rsre3546r-oss/Robert-Smith-Rosario-Estevez-PLC4UNI/Tarea 6/ENSAMBLE/Ensamble PCB Vertical.STEP

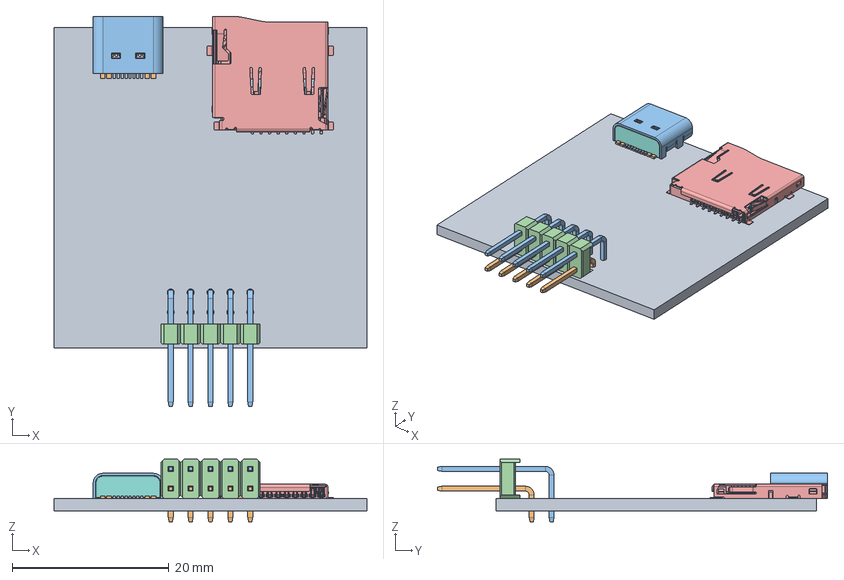
[picture p8: CAD file, 2025-12-02]
Tarea 6/ENSAMBLE/Ensamble PCB Vertical.STEP
40.0 x 49.9 x 8.00 mm
PCB Vertical
2x5 Male Pin Header Angle
Same_Sky_MSD-4-A
USB Type C Port (SMD Type) (1)[1]
