rsre3546r-oss/Robert-Smith-Rosario-Estevez-PLC4UNI/Tarea 2/Fricad/Cuerpo Robert.FCStd

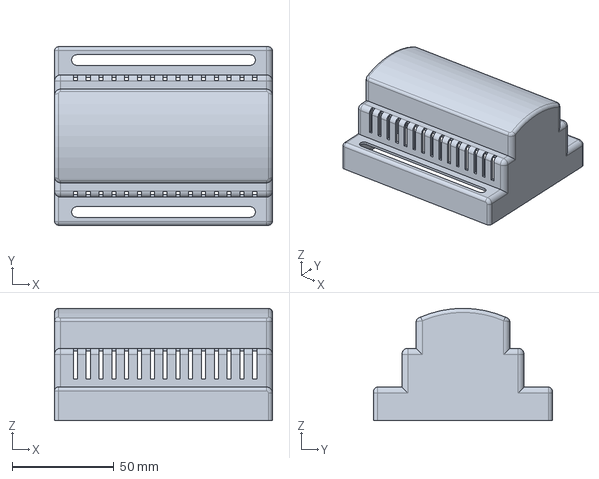
[picture p9: CAD file, 2025-10-09]
Tarea 2/Fricad/Cuerpo Robert.FCStd
107.0 x 87.7 x 55.1 mm
