rsre3546r-oss/Robert-Smith-Rosario-Estevez-PLC4UNI/Tarea 3/Archivos dxf/FreeCad/Tapa Robert-ELECTIVA CAJA-BASE PLC.dxf

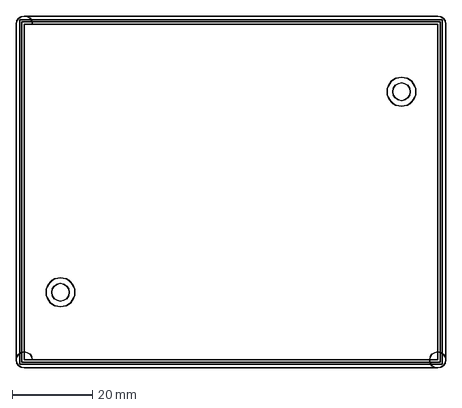
[picture p10: CAD file, 2025-10-09]
Tarea 3/Archivos dxf/FreeCad/Tapa Robert-ELECTIVA CAJA-BASE PLC.dxf
107.0 x 87.7 mm
