rsre3546r-oss/Robert-Smith-Rosario-Estevez-PLC4UNI/Tarea 3/Archivos dxf/SoliEdge/Tapa Robert.dxf

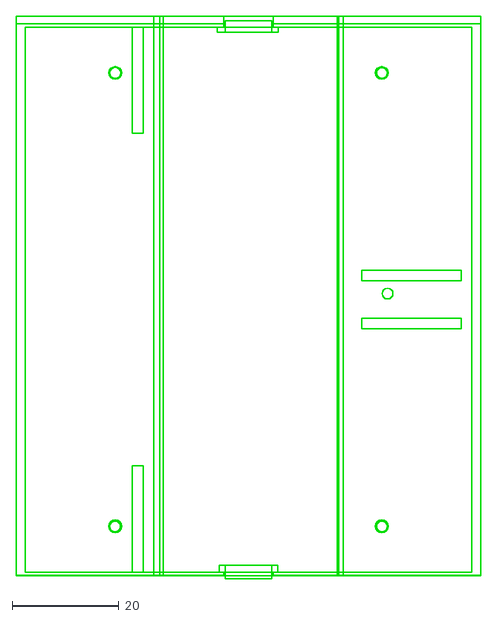
[picture p11: CAD file, 2025-10-09]
Tarea 3/Archivos dxf/SoliEdge/Tapa Robert.dxf
87.0 x 105.4
