rsre3546r-oss/Robert-Smith-Rosario-Estevez-PLC4UNI/Tarea 4/2x5 Male Pin Header Angle.STEP

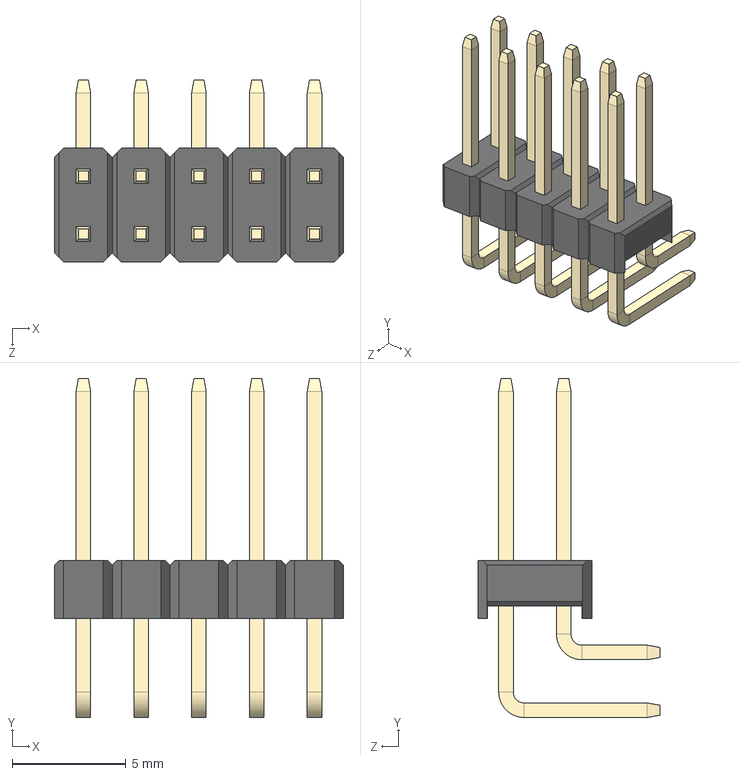
[picture p12: CAD file, 2025-12-02]
Tarea 4/2x5 Male Pin Header Angle.STEP
12.7 x 14.9 x 8.00 mm
