rsre3546r-oss/Robert-Smith-Rosario-Estevez-PLC4UNI/Tarea 6/CONECTORES/USB Type C Port (SMD Type) (1)[1].STEP

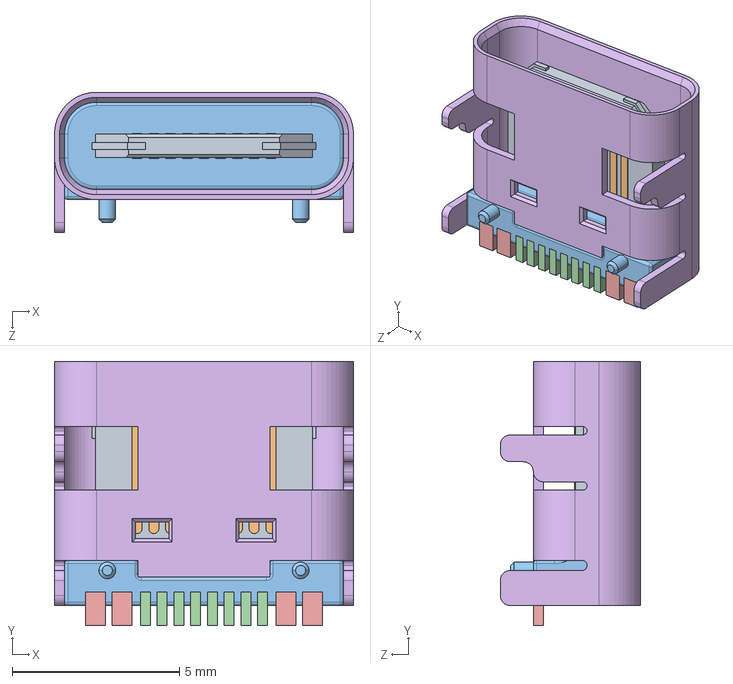
[picture p13: CAD file, 2025-12-11]
Tarea 6/CONECTORES/USB Type C Port (SMD Type) (1)[1].STEP
8.94 x 7.90 x 4.20 mm
