rsre3546r-oss/Robert-Smith-Rosario-Estevez-PLC4UNI/Tarea 2/Fricad/Tapa Robert.FCStd

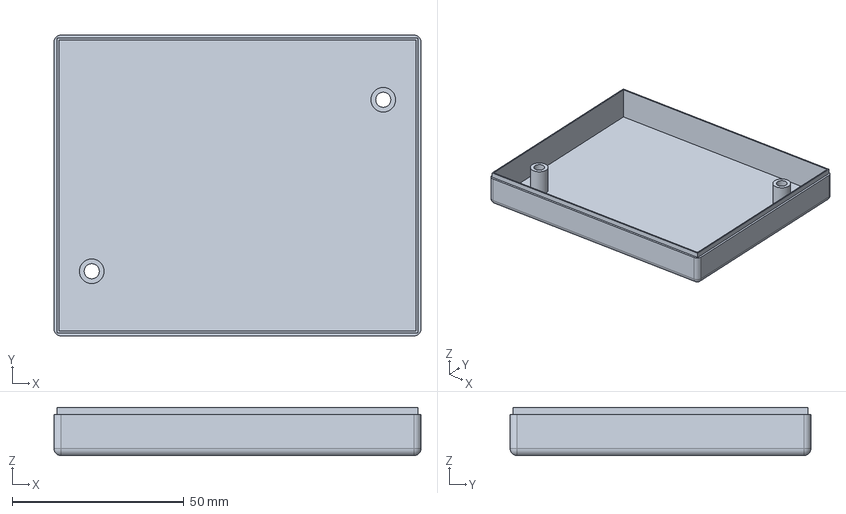
[picture p14: CAD file, 2025-10-09]
Tarea 2/Fricad/Tapa Robert.FCStd
107.0 x 87.7 x 14.0 mm
