rsre3546r-oss/Robert-Smith-Rosario-Estevez-PLC4UNI/Tarea 3/Archivos dxf/FreeCad/Cuerpo Robert-ELECTIVA CAJA PLC.dxf

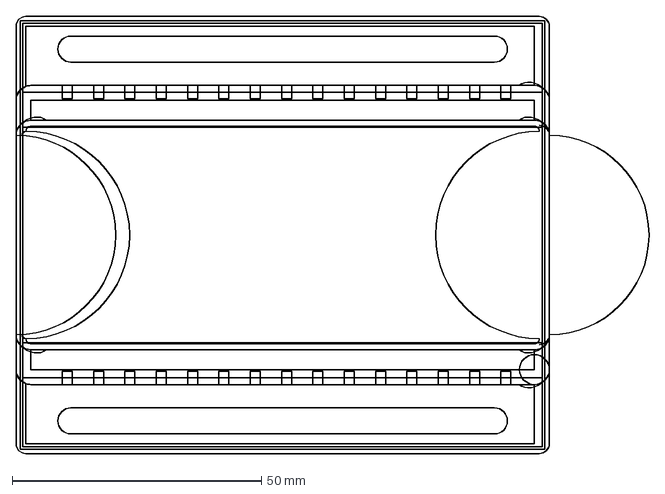
[picture p15: CAD file, 2025-10-09]
Tarea 3/Archivos dxf/FreeCad/Cuerpo Robert-ELECTIVA CAJA PLC.dxf
127.0 x 87.7 mm
