rsre3546r-oss/Robert-Smith-Rosario-Estevez-PLC4UNI/Tarea 3/Archivos dxf/SoliEdge/Cuerpo Robert.dxf

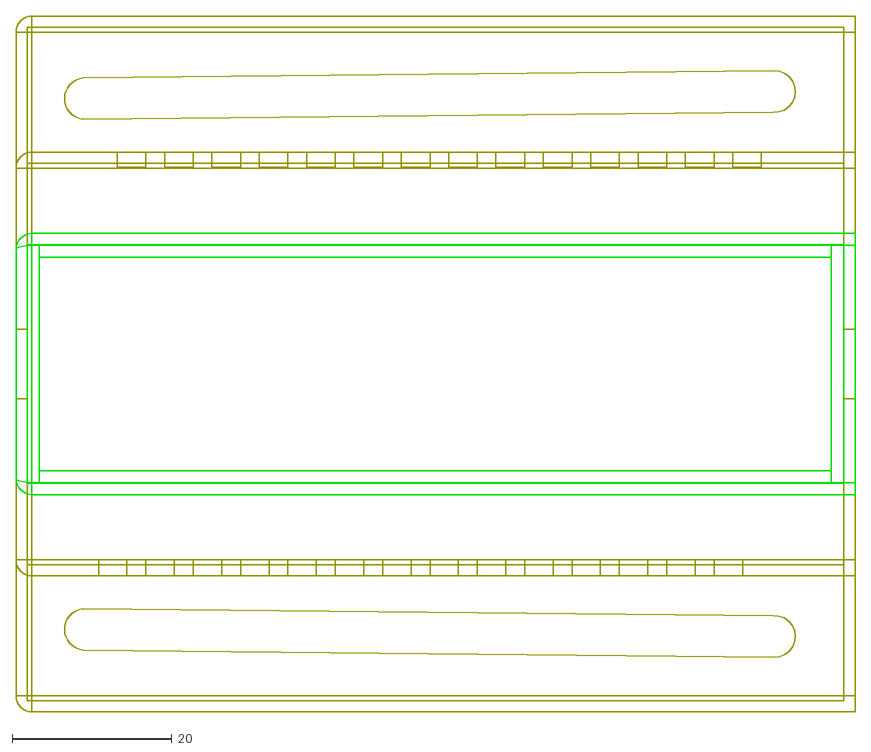
[picture p16: CAD file, 2025-10-09]
Tarea 3/Archivos dxf/SoliEdge/Cuerpo Robert.dxf
104.9 x 87.0
