rsre3546r-oss/Robert-Smith-Rosario-Estevez-PLC4UNI/Tarea 4/Cuerpov2.FCStd

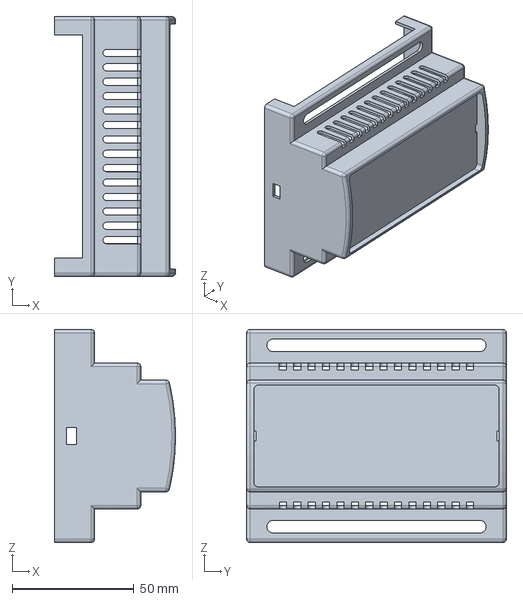
[picture p17: CAD file, 2025-12-02]
Tarea 4/Cuerpov2.FCStd
49.8 x 107.0 x 87.7 mm
