rsre3546r-oss/Robert-Smith-Rosario-Estevez-PLC4UNI/Tarea 6/CONECTORES/Same_Sky_MSD-4-A.step

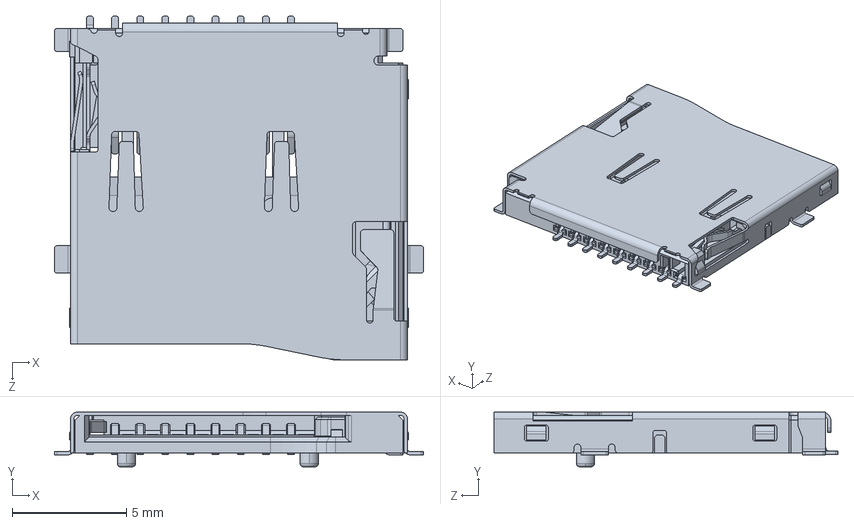
[picture p18: CAD file, 2025-12-11]
Tarea 6/CONECTORES/Same_Sky_MSD-4-A.step
16.1 x 2.40 x 15.0 mm
