rsre3546r-oss/Robert-Smith-Rosario-Estevez-PLC4UNI/Tarea 4/PLC4UNIPCB.step

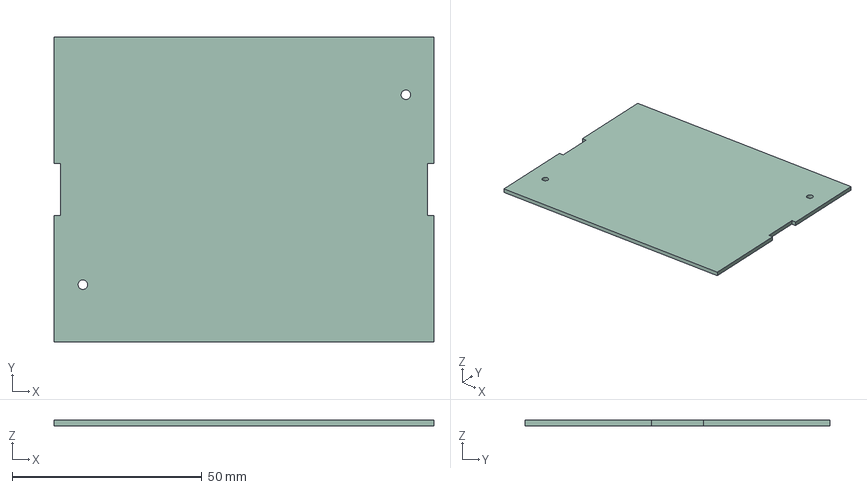
[picture p19: CAD file, 2025-12-02]
Tarea 4/PLC4UNIPCB.step
100.0 x 80.2 x 1.51 mm
