rsre3546r-oss/Robert-Smith-Rosario-Estevez-PLC4UNI/Tarea 4/Tapav2.FCStd

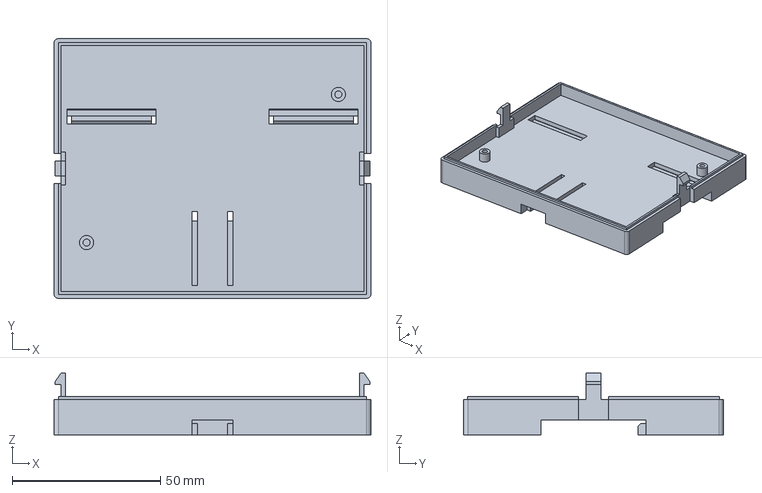
[picture p20: CAD file, 2025-12-02]
Tarea 4/Tapav2.FCStd
107.0 x 87.7 x 20.8 mm
