rsre3546r-oss/Robert-Smith-Rosario-Estevez-PLC4UNI/(list of files, cad)

Other CAD files:
Tarea 4/USB Type C Port (SMD Type) (1).SLDPRT
Tarea 4/PCB4UNIFREECAD.FCStd
Tarea 4/Same_Sky_MSD-4-A.step
