rsre3546r-oss/Robert-Smith-Rosario-Estevez-PLC4UNI/Tarea 6/ENSAMBLE/RENDER1.2.png

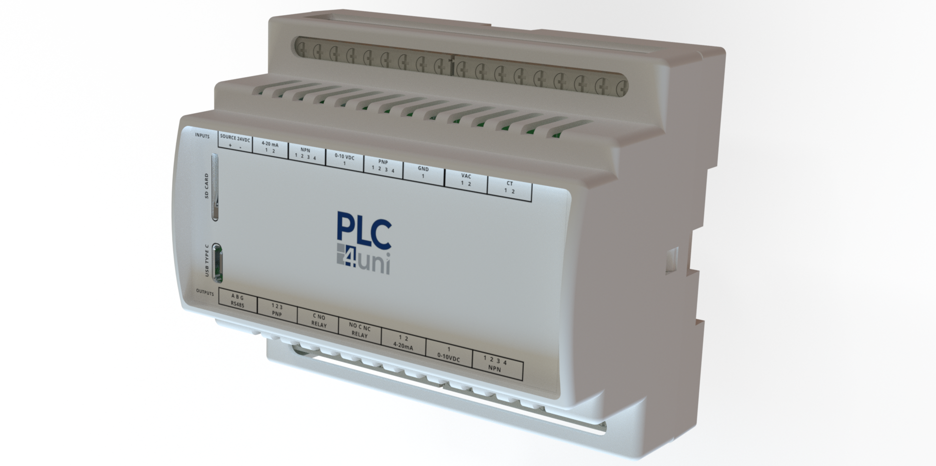
Tarea 6/ENSAMBLE/RENDER1.2.png
