rsre3546r-oss/Robert-Smith-Rosario-Estevez-PLC4UNI/Tarea 2/Boceto/23-156C.PDF

AA

A-A

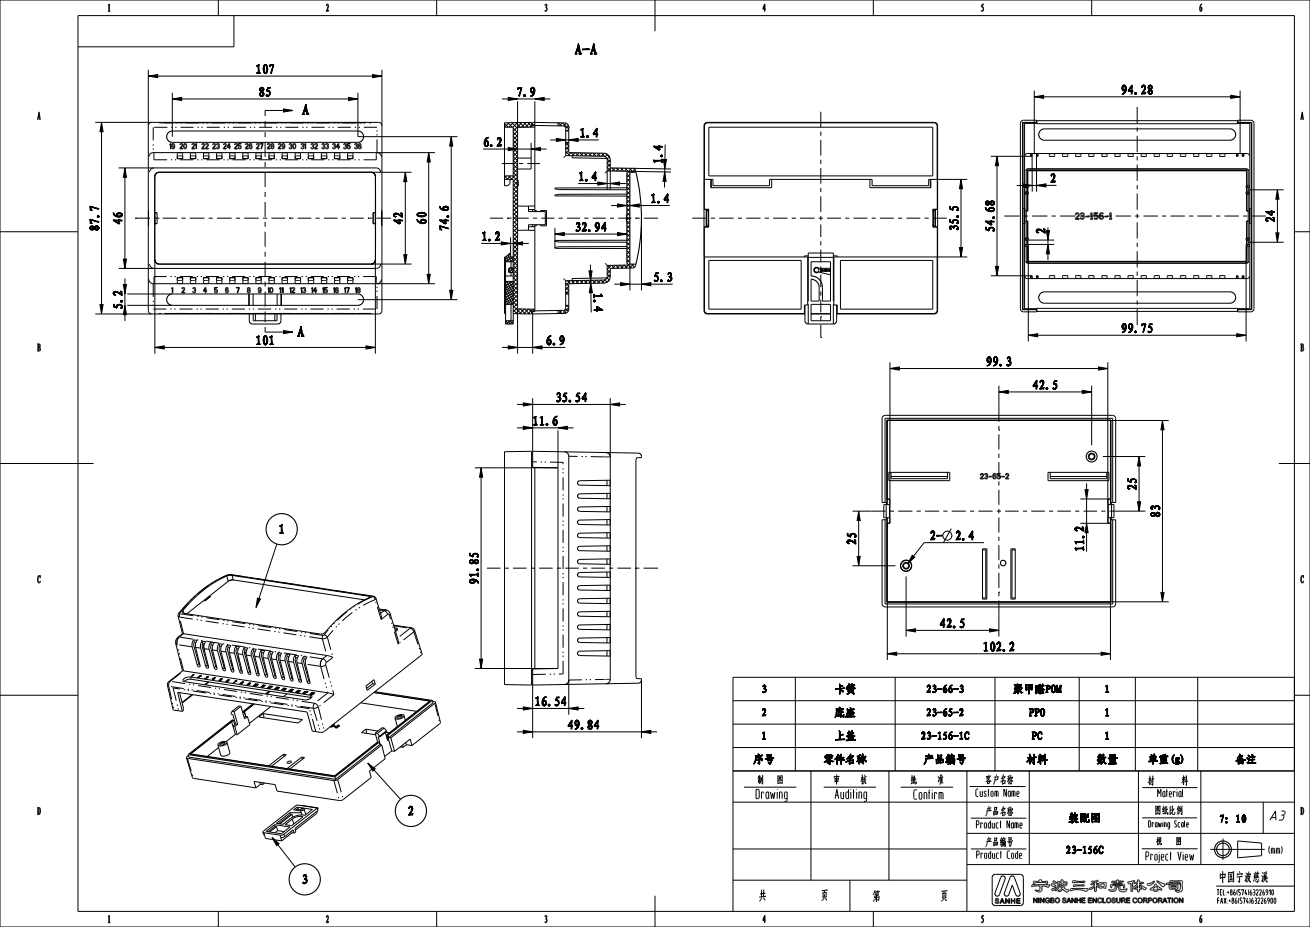
[picture p23: page 1]
零件名称; 产品编号; PPO; 聚甲醛POM; 装配图
