rsre3546r-oss/Robert-Smith-Rosario-Estevez-PLC4UNI/PLC4UNIROBERT1/OUT-NPN-1.kicad_sch

## KiCad design PLC4UNIROBERT1/OUT-NPN-1.kicad_sch (2025-11-18)

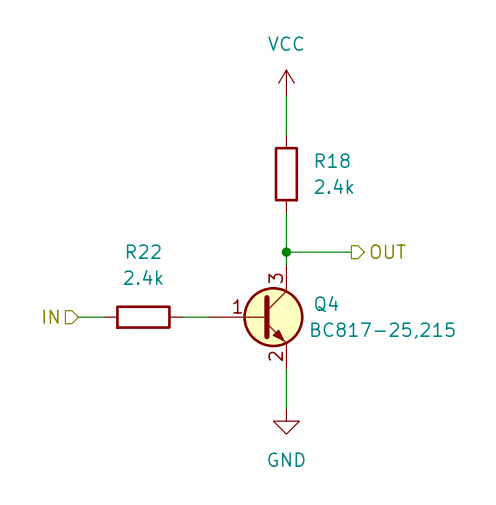
[picture p25: schematic OUT-NPN-1.kicad_sch]

Parts:
Q4: BFN26; SOT-23; Part number BC817-25,215
R18, R22: 2.4k; R_0603_1608Metric

Connections:
GND: Q4.2 (E)
IN: R22.1
unnamed: Q4.1 (B), R22.2
OUT: Q4.3 (C), R18.1
VCC: R18.2
