rsre3546r-oss/Robert-Smith-Rosario-Estevez-PLC4UNI/PLC4UNIROBERT1/OUTPUT-0-10V.kicad_sch

## KiCad design PLC4UNIROBERT1/OUTPUT-0-10V.kicad_sch (2025-11-18)

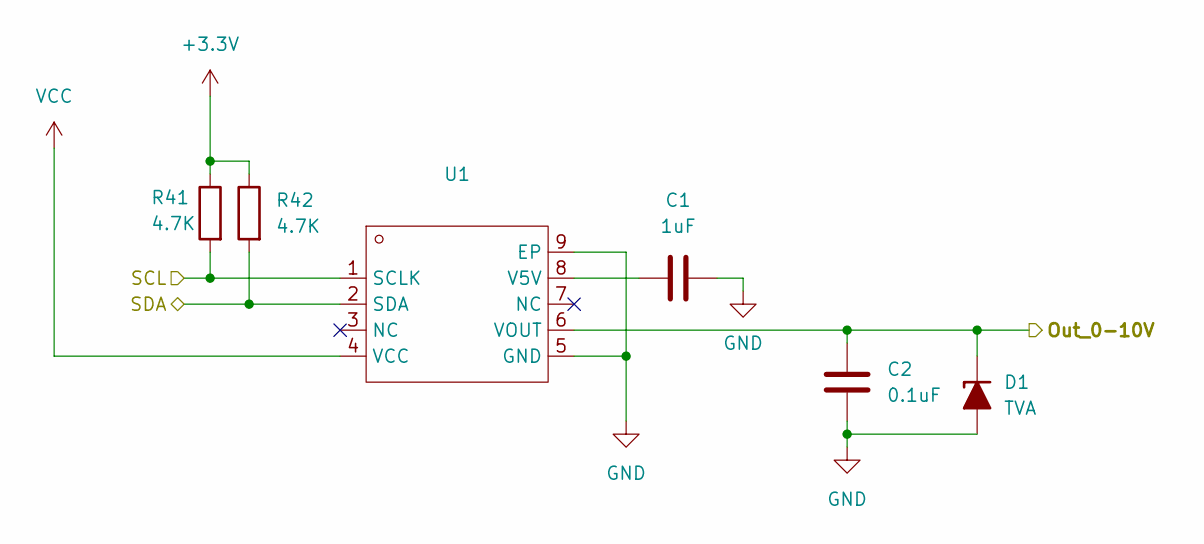
[picture p28: schematic OUTPUT-0-10V.kicad_sch]

Parts:
C1: 1uF; C_0201_0603Metric; LCSC C1592
C2: 0.1uF; C_0201_0603Metric; LCSC C66501
D1: TVA; D_0201_0603Metric_TVS; LCSC C18199535
R41, R42: 4.7K; R_0603_1608Metric
U1: Sensirion_DFN-8-1EP_2.5x2.5mm_P0.5mm_EP1.1x1.7mm; LCSC C3152008

Connections:
+3.3V: R41.2, R42.2
GND: C1.2, C2.1, D1.2 (A), U1.5 (GND), U1.9 (EP)
unnamed: C1.1, U1.8 (V5V)
Out_0-10V: C2.2, D1.1 (K), U1.6 (VOUT)
SCL: R41.1, U1.1 (SCLK)
SDA: R42.1, U1.2 (SDA)
VCC: U1.4 (VCC)
