rsre3546r-oss/Robert-Smith-Rosario-Estevez-PLC4UNI/PLC4UNIROBERT1/PLC4UNIROBERT1.kicad_sch

## KiCad design PLC4UNIROBERT1/PLC4UNIROBERT1.kicad_sch (2025-11-18)

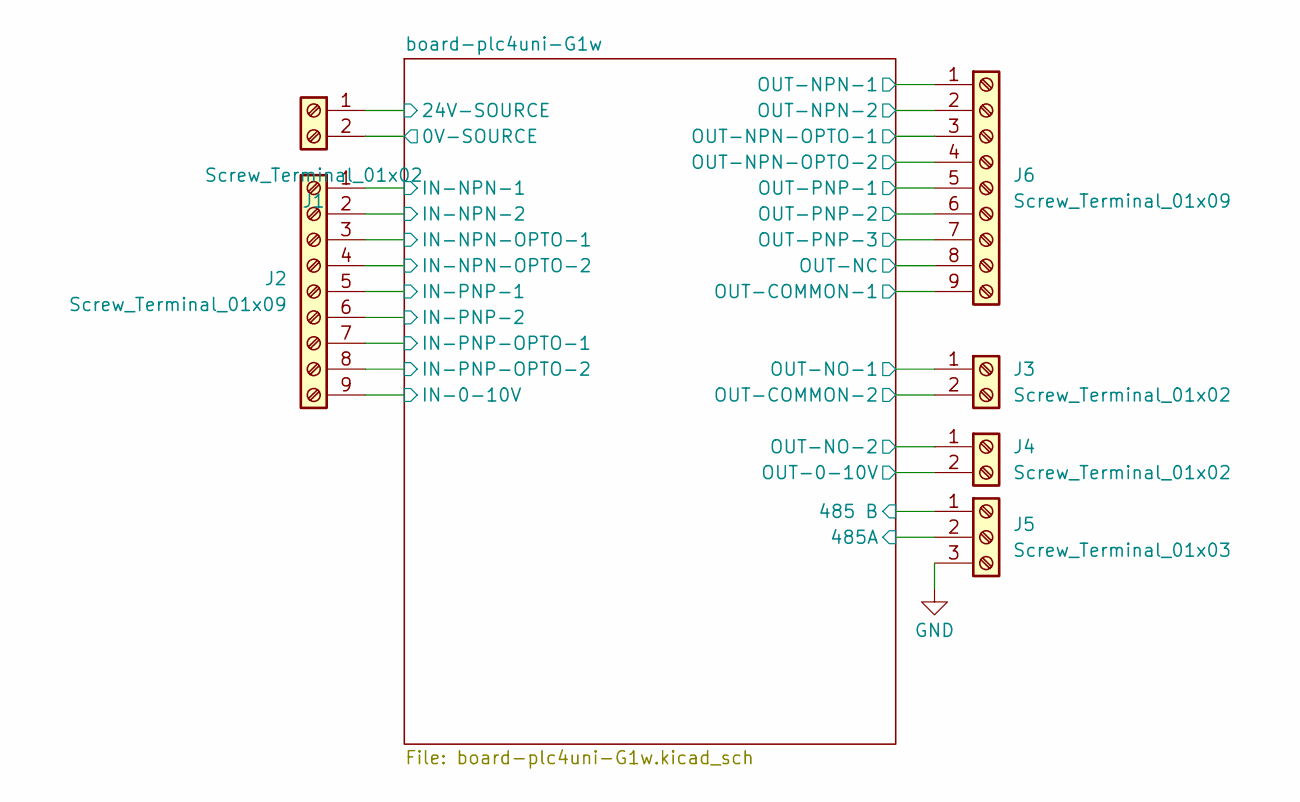
[picture p29: schematic PLC4UNIROBERT1.kicad_sch]

Parts:
J1, J3, J4: Screw_Terminal_01x02; TerminalBlock_Phoenix_PT-1,5-2-5.0-H_1x02_P5.00mm_Horizontal
J2, J6: Screw_Terminal_01x09; TerminalBlock_Phoenix_PT-1,5-9-5.0-H_1x09_P5.00mm_Horizontal
J5: Screw_Terminal_01x03; TerminalBlock_Phoenix_PT-1,5-3-5.0-H_1x03_P5.00mm_Horizontal

Connections:
0V-SOURCE: J1.2
24V-SOURCE: J1.1
485 B: J5.1
485A: J5.2
GND: J5.3
IN-0-10V: J2.9
IN-NPN-1: J2.1
IN-NPN-2: J2.2
IN-NPN-OPTO-1: J2.3
IN-NPN-OPTO-2: J2.4
IN-PNP-1: J2.5
IN-PNP-2: J2.6
IN-PNP-OPTO-1: J2.7
IN-PNP-OPTO-2: J2.8
OUT-0-10V: J4.2
OUT-COMMON-1: J6.9
OUT-COMMON-2: J3.2
OUT-NC: J6.8
OUT-NO-1: J3.1
OUT-NO-2: J4.1
OUT-NPN-1: J6.1
OUT-NPN-2: J6.2
OUT-NPN-OPTO-1: J6.3
OUT-NPN-OPTO-2: J6.4
OUT-PNP-1: J6.5
OUT-PNP-2: J6.6
OUT-PNP-3: J6.7
