rsre3546r-oss/Robert-Smith-Rosario-Estevez-PLC4UNI/PLC4UNIROBERT1/RS485.kicad_sch

## KiCad design PLC4UNIROBERT1/RS485.kicad_sch (2025-11-18)

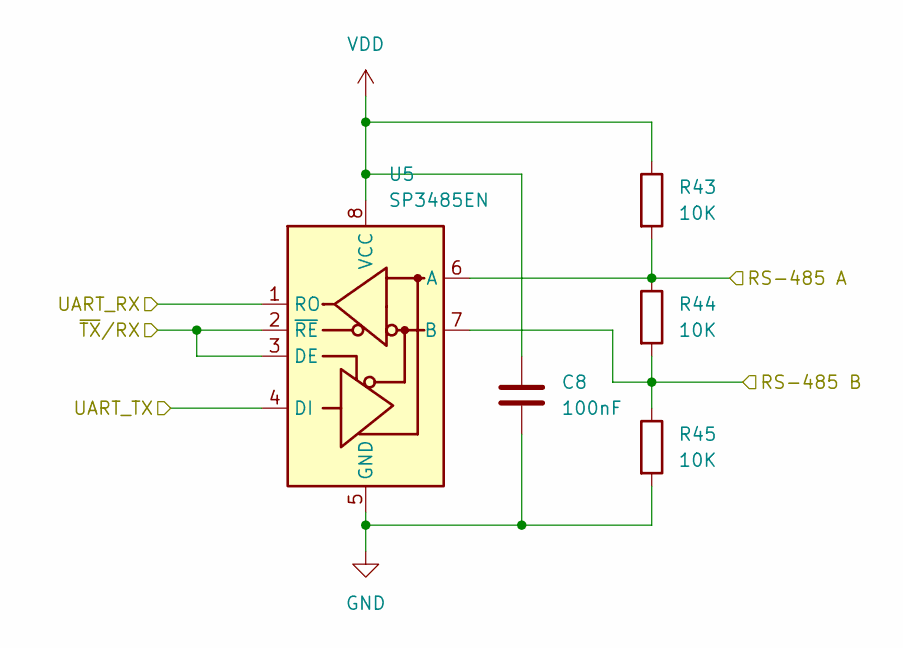
[picture p30: schematic RS485.kicad_sch]

Parts:
C8: 100nF; C_0201_0603Metric
R43, R44, R45: 10K; R_0603_1608Metric
U5: SP3485EN; SOIC-8_3.9x4.9mm_P1.27mm

Connections:
GND: C8.2, R45.2, U5.5 (GND)
RS-485 A: R43.2, R44.1, U5.6 (A)
RS-485 B: R44.2, R45.1, U5.7 (B)
UART_RX: U5.1 (RO)
UART_TX: U5.4 (DI)
VDD: C8.1, R43.1, U5.8 (VCC)
~TX/RX: U5.2 (~RE), U5.3 (DE)
