rsre3546r-oss/Robert-Smith-Rosario-Estevez-PLC4UNI/PLC4UNIROBERT1/input-npn.kicad_sch

## KiCad design PLC4UNIROBERT1/input-npn.kicad_sch (2025-11-18)

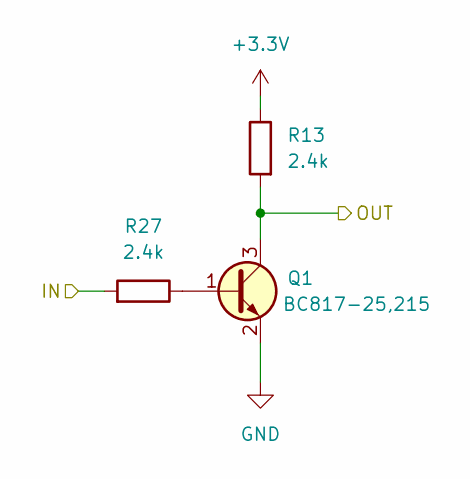
[picture p32: schematic input-npn.kicad_sch]

Parts:
Q1: BFN26; SOT-23; Part number BC817-25,215
R13, R27: 2.4k; R_0603_1608Metric

Connections:
+3.3V: R13.2
GND: Q1.2 (E)
IN: R27.1
unnamed: Q1.1 (B), R27.2
OUT: Q1.3 (C), R13.1
