rsre3546r-oss/Robert-Smith-Rosario-Estevez-PLC4UNI/PLC4UNIROBERT1/input-pnp-opto.kicad_sch

## KiCad design PLC4UNIROBERT1/input-pnp-opto.kicad_sch (2025-11-18)

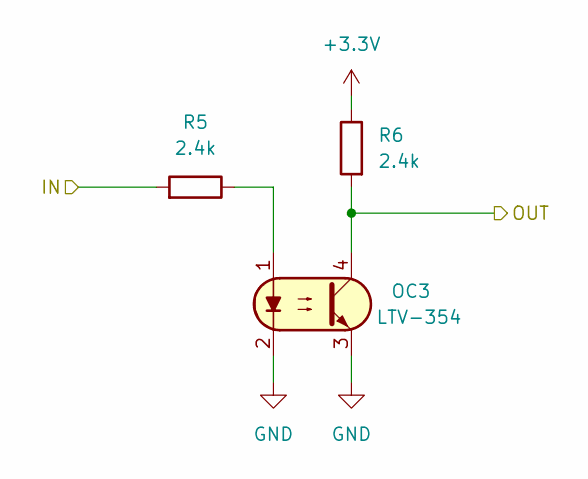
[picture p33: schematic input-pnp-opto.kicad_sch]

Parts:
OC3: FOD817S; SMDIP-4_W9.53mm; Part Number LTV-354
R5, R6: 2.4k; R_0603_1608Metric

Connections:
+3.3V: R6.2
GND: OC3.2, OC3.3
IN: R5.1
unnamed: OC3.1, R5.2
OUT: OC3.4, R6.1
